Erriez/ESPHomePCPowerControlHomeAssistant/kicad/HomeAssistantNASPowerHomeAssistant.png

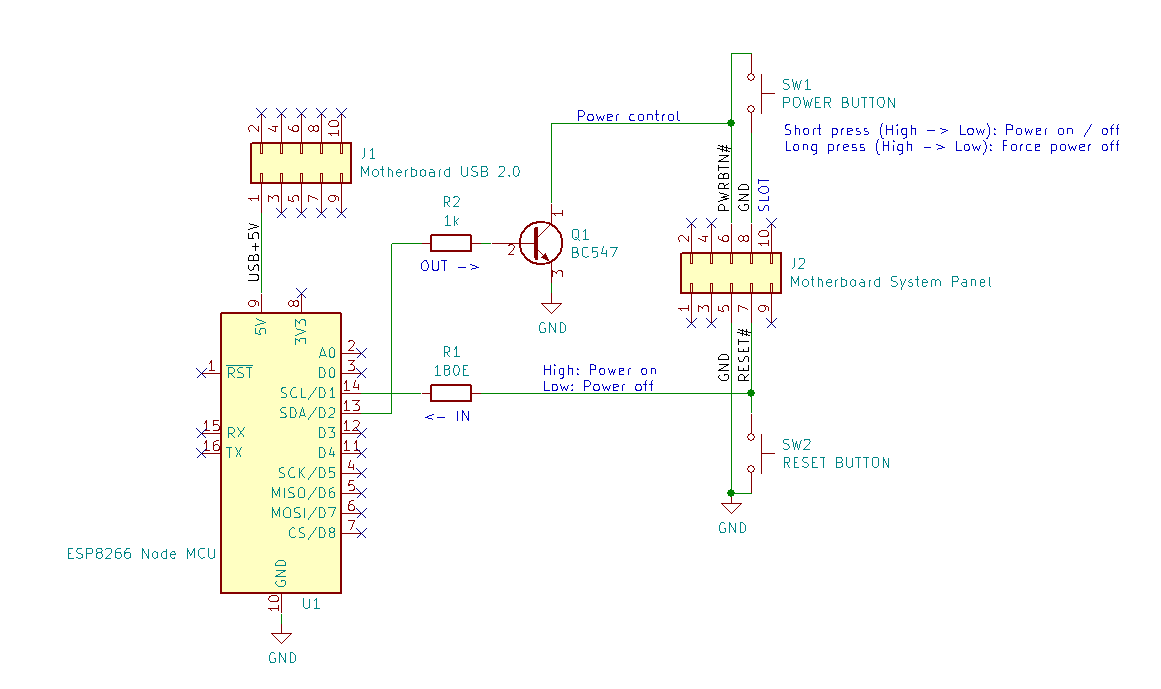
kicad/HomeAssistantNASPowerHomeAssistant.png
