Erriez/ESPHomePCPowerControlHomeAssistant/kicad/Z97 Extreme4 - System Panel Header.png

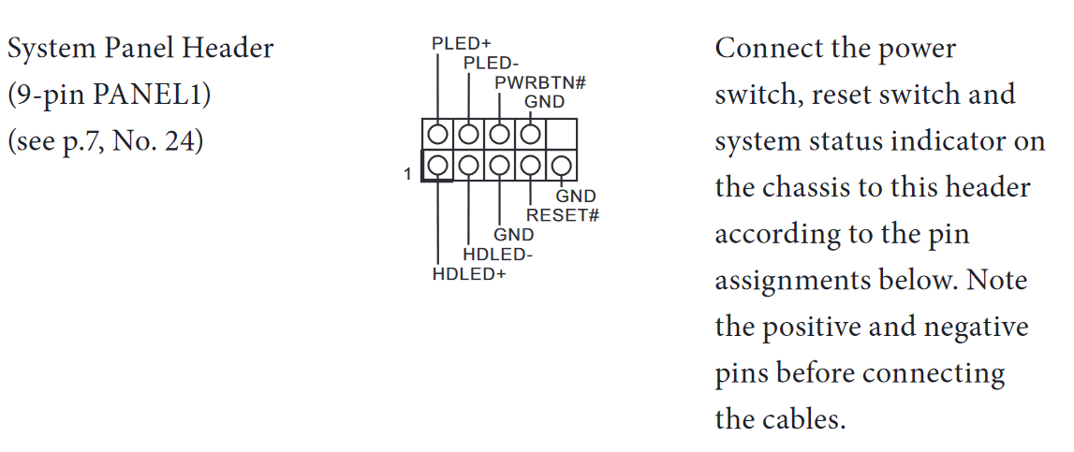
kicad/Z97 Extreme4 - System Panel Header.png
