Erriez/ESPHomePCPowerControlHomeAssistant/kicad/Z97 Extreme4 - USB 2.0 Header.png

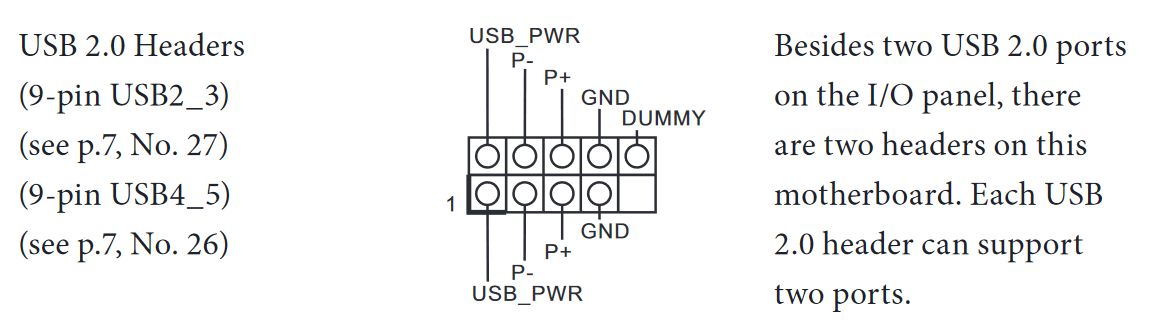
kicad/Z97 Extreme4 - USB 2.0 Header.png
