Erriez/ESPHomePCPowerControlHomeAssistant/kicad/ESP8266-ESPHome-PC-Power-HomeAssistant.sch

## KiCad design kicad/ESP8266-ESPHome-PC-Power-HomeAssistant.sch (2021-05-24)

Schematic: ESP8266-ESPHome-PC-Power-HomeAssistant.sch

Parts:
J1: Motherboard USB 2.0
J2: Motherboard System Panel
Q1: BC547; TO-92_Inline
R1: 180E
R2: 1k
SW1: POWER BUTTON
SW2: RESET BUTTON
U1: ESP8266 Node MCU; WEMOS_D1_mini_light

Notes on the sheet:
SLOT
High: Power on Low: Power off
Short press (High -> Low): Power on / off Long press (High -> Low): Force power off
Power control
<- IN
OUT ->
