Erriez/ESPHomePCPowerControlHomeAssistant/(threads)

Thread 1 (2021-09-26):

R1 and R2 specs

zhulik, 2021-09-26:
Hello,

I'm new to electronics but I'd like to build your device. Probably I don't know how to properly use KiCad and find the information in the blueprints, but could you please specify specs or exact models of R1 and R2?

Erriez, 2021-09-26:
Hi @zhulik, Resistor R1 is 180Ohm 1/4Watt and R2 is 1kOhm 1/4Watt. The package depends on the type you want to solder on the PCB, such as TH (Through Hole) or SMD. You can use any resistor package and is not critical. Success!

Closed 2021-09-27.

Thread 2 (2022-08-17):

Parts list

That-Dude, 2022-08-17:
Cool project! I would like to build this but I'm struggling with the value of resistor R1 on your schematic 1B0E ?

Erriez, 2022-08-19:
@That-Dude Thanks for your feedback! Resistor R1 is 180Ohm. Sorry, it is a typo. For more information, please refer to https://github.com/Erriez/ESPHomePCPowerControlHomeAssistant/issues/1

Closed 2022-08-19.

Thread 4 (2022-09-09):

Typing error in circuit

jnsw, 2022-09-09:
https://github.com/Erriez/ESPHomePCPowerControlHomeAssistant/blob/master/README.md

```
[...]
Pin D1 is used to read the power status from the reset pin: High is on, Low is off. Transistor Q1 is used for secure isolation between ESP8266 and motherboard.

Pin D2 is used to pull the power button low to generate a short or long press. Resistor R1 is used to minimize current when the IO pin is accidentally set to output.
[...]
```

it's written different than on the picture, which description is correct? the image or the text?

Erriez, 2022-09-10:
Hi @jnsw, Thanks for your feedback. The schematic and text in the `README.md` matches as follows:

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

* Pin `D1` is the power status (monitor) ESP input pin: It is used to monitor the motherboard power state. Arrow `<- IN` below the `R1`.
* Pin `D2` is an ESP output pin to control the power button. Arrow `OUT ->` below `R2`.

Does this answer your question?

Closed 2022-09-19.

Thread 5 (2023-02-01):

Reset pin

nvtkaszpir, 2023-02-01:
Question:
Usually motherboard J2 header has pins which are used to turn on leds to show on the computer case that the computer is on.

Why not use that for pc power status, and use reset button in similar way as power button is used (this way allowing computer reset without forced powering down)?

Erriez, 2023-02-02:
@nvtkaszpir Thanks for your feedback. You're right, the power LED can be used as well to detect the power state. I started with a motherboard where this LED was not available and designed 2 IO pins. If you have sufficient ESP8266 or ESP32 IO pins available, you can for example configure:
- 1 output pin for power button
- 1 output pin for reset button
- 1 input pin to read the power state from the LED
So it is flexible and a starting point for your needs.

nvtkaszpir, 2023-02-02:
Ah ok, now it's more clear what were limitations of the design.
Thanks!

Closed 2023-02-02.

Thread 7 (2023-06-20):

Reset button always is 5v

GrzesiuS, 2023-06-20:
Hello,

I followed all instructions and can turn on/off my PC but detection from the reset pin is impossible because it's always in the high state even if the PC is disabled. I plan to use reset GND to detect low state.

Do you think it's a good idea?

Erriez, 2023-06-20:
Yes, you can try other pins as well as it is motherboard specific. Succes!

GrzesiuS, 2023-06-20:
I tried the power LED but the behavior is the same :|

Erriez, 2023-06-20:
Is the LED pin 3V3? Can you check the wiring, for example by pulling the ESP input pin high/low manually to see if this works?

GrzesiuS, 2023-06-20:
it's 5V bo I got another idea. I use 3.3V from power supply (orange cable) :)

Erriez, 2023-06-21:
Sounds good. Please notice that the ESP8266/ESP32 pins are 3V3 tolerant. It may work with 5V input, but is beyond the absolute maximum ratings and may damage input pins. Success!

Closed 2023-06-21.

Thread 10 (2023-08-18):

Invoke power button without homeassistant (by MQTT / API via Browser)

backupandforkacc, 2023-08-18:
Thank you for this nice project.

Is there a chance to invoke the power button action without a homeassistant installation?

The easiest would be a dashboard directly on the ESP, another ways would be via the API. I have read some ESP Home documentation, but I am not a programmer and failed so far to find a link to something to invoke by browser. I have limited knowledge about ESP.

jojo-Hub, 2023-09-17:
Yes, this can be done easily with the [web server component](https://esphome.io/components/web_server.html#web-server-component): just add

`web_server:`

to the .yaml-config file and enter your ESP's IP into a browser in the same network.

Some documentation said that without an HA-connection, the ESP will reset and re-initialize every 15 min (I have not searched how to disable this). But as long as the ESP-init dos not interfere with the pins used to connect to your PC's power and reset line, everything should be fine. Have a look at the [ESP documenttion](https://randomnerdtutorials.com/esp32-pinout-reference-gpios/) for further information.

BTW: You can even make a [remote control](https://community.home-assistant.io/t/esphome-to-esphome-direct-communication/101370/7) with a button attached to a second ESP-board. This also works without a running HA-server.

Erriez, 2023-09-18:
@backupandforkacc and @jojo-Hub Thanks for your details. I was not aware of the ESP webserver component and is useful for other projects as well. I'll close this issue as the original question is answered.

Closed 2023-09-18.

Thread 11 (2023-10-18):

PIN14 always returns "1"

pixelwave, 2023-10-18:
I tried to replicate your project, so far power on works. But somehow my PIN32 (reads RESET pin from mainboard) always returns "1" no matter if power button pressed and pc running or not. I only shows "0" when I unplug the mainboard completely?

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

My ESP32 test code:

```
import machine
import time

# Define the pin for the LED and the boot button
led_pin = machine.Pin(2, machine.Pin.OUT)
button_pin = machine.Pin(0, machine.Pin.IN)
power_pin = machine.Pin(13, machine.Pin.OUT)
reset_pin = machine.Pin(32, machine.Pin.IN)

# Function to turn on the LED
def turn_on_led(pin):
    pin.on()

# Function to turn off the LED
def turn_off_led(pin):
    pin.off()

# Main loop
while True:
    if button_pin.value() == 0:
        turn_on_led(led_pin)
        power_pin.on()
    else:
        turn_off_led(led_pin)
        power_pin.off()

    print("Power State:", reset_pin.value())

```

pixelwave, 2023-10-18:
I figured out ... what works though ... if I connect PIN32 to POWER_LED+ on the ATX header. Is that safe to do?

Erriez, 2023-10-22:
@pixelwave Thanks for using this project. Reading the computer power state is motherboard dependent. What works for you may not work on another motherboard as it is not standardized. When the reset pin does not work, I also recommend to use a different pin like the power LED. When the input pin of the ESP32 does not exceed 3.3V, then you can use this pin. Otherwise you can use an optocoupler for isolation. Success!

pixelwave, 2023-10-23:
Thanks for the reply! Yes I was quite confused that it works in your case. After my research usually the feedback was:

`The reset pin on a PC motherboard is typically used to perform a hardware reset of the computer, forcing it to restart. It is not designed to provide information about the power state of the PC. The reset pin is a momentary contact switch or signal that, when triggered, causes the computer to reset and begin the boot process.`

I went exactly down the road that you suggested in the meantime. With the help of the reddit community I came up with this scheme using optocouplers and the power LED. I assembled it - and it works!

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

Btw .. do you have a tip for a good online forum / community where ESP32/electronics stuff like this can be discussed?

Erriez, 2023-10-25:
Good to hear that you found a solution. I probably designed exactly this schematic when opto isolation is required. So well done. :-)

> Btw .. do you have a tip for a good online forum / community where ESP32/electronics stuff like this can be discussed?

I recommend https://hardwarerecs.stackexchange.com which if pretty new / Stackoverflow or Reddit.

I assume this issue can be closed. Otherwise let me know.

Closed 2023-10-25.

Thread 12 (2024-10-11):

pin used multiple times

beireken, 2024-10-11:
Recent esphome throws an error because the switch pin is used multiple times in the yaml.

I had to change the config to:

```
switch:
  - platform: gpio
    name: "PC Power Toggle"
    icon: "mdi:electric-switch"
    pin:
      number: D1   # Power button output pin
      allow_other_uses: true
    id: power_short_press
    inverted: no
    on_turn_on:
    - delay: 150ms
    - switch.turn_off: power_short_press
  - platform: gpio
    name: "PC HARD POWER OFF"
    icon: "mdi:electric-switch"
    pin:
      number: D1   # Power button output pin
      allow_other_uses: true
    id: power_long_press
    inverted: no
    on_turn_on:
    - delay: 3500ms
    - switch.turn_off: power_long_press
```

The it compiles fine.

Erriez, 2024-10-11:
@beireken Thanks for using my project and time to report this issue. I was able to reproduce the problem and was not aware that the ESPHome `yaml` file format changed. Some more updates are required according to the documentation:
* `esp8266` or `esp32` moved to a separate line. (Was single line: `platform: ESP8266 # ESP8266 or ESP32`).
* Line `- platform: esphome` must be added to `ota` section.
* `inverted` option moved to `pin`.
* New pin `mode` configuration under `pin`.

I've created this version:

```yaml
esphome:
  name: pc-power

# ESP8266 board
esp8266:
  board: nodemcuv2

# Or: ESP32 board (comment out esp8266)
# esp32:
#   lolin_d32

# WiFi connection to base station
wifi:
  ssid: !secret esphome_wifi_ssid
  password: !secret esphome_wifi_password

  # Enable fallback hotspot (captive portal) in case wifi connection fails
  ap:
    ssid: "PC Power Fallback Hotspot"
    password: !secret esphome_ap_password

# captive_portal:

# Enable logging
logger:

# Enable Home Assistant API
api:
  password: !secret esphome_api_password

# Enable OTA update via WiFi
ota:
  - platform: esphome
    password: !secret esphome_ota_password

switch:
  - platform: gpio
    id: power_short_press
    name: "PC Power Toggle"
    icon: "mdi:electric-switch"
    pin:
      number: D2   # Power button output pin
      inverted: false
      allow_other_uses: true
      mode:
        output: true
    on_turn_on:
    - delay: 150ms
    - switch.turn_off: power_short_press
  - platform: gpio
    id: power_long_press
    name: "PC HARD POWER OFF"
    icon: "mdi:electric-switch"
    pin:
      number: D2   # Power button output pin
      inverted: false
      allow_other_uses: true
      mode:
        output: true
    on_turn_on:
    - delay: 3500ms
    - switch.turn_off: power_long_press

binary_sensor:
  - platform: gpio
    name: "PC Power State"
    device_class: power
    pin:
      number: D1   # Power detect input pin (readback from Reset button)
      inverted: false
      mode:
        input: true
        pullup: true
```

```
$ esphome compile pc-power.yaml
INFO ESPHome 2024.9.2
INFO Reading configuration pc-power.yaml...
INFO Generating C++ source...
INFO Compiling app...
Processing pc-power (board: nodemcuv2; framework: arduino; platform: platformio/espressif8266@4.2.1)
------------------------------------------------------------------------------------------------------------------------------------------
HARDWARE: ESP8266 80MHz, 80KB RAM, 4MB Flash
Dependency Graph
|-- ESP8266WiFi @ 1.0
|-- ESP8266mDNS @ 1.2
RAM:   [====      ]  38.1% (used 31220 bytes from 81920 bytes)
Flash: [====      ]  35.2% (used 367639 bytes from 1044464 bytes)
====================================================== [SUCCESS] Took 0.90 seconds ======================================================
INFO Successfully compiled program.
```

Can you check if this version works? Then I'll update the yaml file.

Note: In your version you changed to pin D1 which should be D2 to match with the schematic.

Thanks!

beireken, 2024-10-11:
Yes, your yaml works fine!

Not sure why i'm using the D1 pin  actually...i'm using this module for nearly a year i think.
I don't use the sensor part though, i forgot why, guess i got lazy at some point and just left it in the pc :)
I use a ping as my on sensor at the moment, :D

Erriez, 2024-10-12:
Thanks for letting me know! I've merged the updates and released v1.0.1.

Closed 2024-10-12.

Thread 15 (2025-01-14):

USB on mainbaord is allways on and resetpin allways high

Baumart, 2025-01-14:
I don't know why, but on my mainboard the reset pin is always high when I power the USB, or have I done something wrong?

Erriez, 2025-01-14:
Thanks for your report. Correct, on some motherboards, the USB ports are always power. The power of the reset pin varies between motherboards. In this case, a recommendation is to find another pin such as a power LED. Is this available on your motherboard for power detection?

Thread 16 (2025-08-27):

Reset button boot loop

dadodasyra, 2025-08-27:
As soon as i ground the reset button of my Z690 prime the pc enters a boot loop.
What could i do to read the pc state then ?

Erriez, 2025-08-29:
Thanks for using this project. To detect the PC power on or off status, an ESP8266 or ESP32 pin should be connected to a motherboard pin which reflects the power status. Unfortunately, this connection and behavior is different for every motherboard and beyond the scope of this project.

Closed 2025-08-29.
