Erriez/ESPHomePCPowerControlHomeAssistant/(commit log)

2021-05-24 Initial checkin
    [ESP8266-ESPHome-PC-Power-HomeAssistant.sch]
2022-01-15 Add Python script to control power via HA
2022-02-13 Change pin control timing
    - The HA automation script is no longer required and can be removed.
    - Renamed button/sense.
    - Updated documentation.
2023-07-13 Update README.md
    Updated schematic description
